CyrusGuest/smartbattery/pcb/v2-integrated/README.md

# Smart Battery PCB — v2 (Integrated SMD)

Production-target board: fully integrated SMD design, JLCPCB PCBA-assembled, no plug-in modules. Replaces the v1 carrier prototype at `../v1-carrier/`.

## Goals

- **Compact**: target ≤ 30 × 80 mm, fits in a Geekbar-style enclosure alongside a 1S LiPo pouch
- **Mass-producible**: every part on JLCPCB's Basic or Extended catalog, all SMD, single-side population where feasible
- **No hand-soldering**: end user receives an assembled PCBA from JLCPCB
- **USB-C flashing & charging**: single port for both, no extra programmer needed
- **Looks like a real product**: tasteful PCB silkscreen, components arranged so the housing can be a clean rectangular envelope

## Block diagram

```
USB-C ──┬──► TP4056 (charger) ──► P+ ─┬──► INA219.V- (= +SYS)
        │                             │
        │     CC1/CC2 = 5.1k pdwn     │
        ▼                             │
       ESD                            │
        │                             │
        ▼                             │
  ESP32-S3 D+/D-                      │
                                      │
Cell+ ──► INA219.V+ ──[shunt 0.1Ω]──┘
Cell− ──► FS8205A ──► (DW01A controls) ──► system GND

+SYS ──► TPS63031DSK ──► +3V3 ──► ESP32-S3, INA219_logic, OLED

ESP32-S3:
  GPIO 6  ──► R(220) ──► AO3400A gate ──┐
                          │              │
  GPIO 4 ◄── fire switch  ▼              ▼
  GPIO 5/11/16/17/18  → OLED SPI    drain ──► coil ──► J4 (510 thread)
  GPIO 8/9  → I²C ── INA219          source ─► GND     +SYS ──► coil top
  GPIO 19/20 → USB D-/D+ (native)    SS34 flyback drain↔+SYS
```

## BOM (target parts)

| Ref | Part | Package | LCSC?  | Notes |
|---|---|---|---|---|
| U1 | ESP32-S3-MINI-1-N4 | LGA-65 module  | basic  | 4 MB flash, no PSRAM, PCB antenna |
| U2 | TP4056-42-ESOP8 | ESOP-8 | basic  | 1 A charger; PROG = 1.2 kΩ |
| U3 | DW01A | SOT-23-6 | basic  | Cell over-discharge / over-charge / over-current control |
| U4 | FS8205A | SOT-23-6 | basic  | Dual N-MOSFET for protection |
| U5 | INA219AIDR | SOIC-8 | basic  | Bus voltage + current sense, addr 0x40 |
| U6 | TPS63031DSK | SON-10 | extended | Buck-boost, fixed 3.3 V, ≤500 mA |
| Q1 | AO3400A | SOT-23 | basic  | Coil-drive N-MOSFET |
| D1 | SS34 | SMA | basic  | Flyback Schottky |
| D2 | USBLC6-2SC6 | SOT-23-6 | basic  | USB ESD protection |
| LED1,2 | 0603 LED green / red | 0603 | basic  | Charge / standby indicators |
| L1 | 1.5 µH 2.2A | 1210 | basic  | TPS63031 inductor |
| Rshunt | 0.1 Ω 1% 1 W | 2512 | basic  | INA219 sense (matches firmware calibration) |
| R1, R2 | 5.1 kΩ | 0603 | basic  | USB-C CC pull-downs (USB2-only sink) |
| Rprog | 1.2 kΩ | 0603 | basic  | TP4056 charge current → 1 A |
| R_LED1,2 | 1 kΩ | 0603 | basic  | LED current limit |
| Rg | 220 Ω | 0603 | basic  | MOSFET gate series |
| Rgs | 100 kΩ | 0603 | basic  | MOSFET gate-source pull-down |
| Rsda,scl | 4.7 kΩ | 0603 | basic  | I²C pull-ups |
| Ren | 10 kΩ | 0603 | basic  | ESP32 EN pull-up |
| C_in,out | 10 µF / 22 µF MLCC | 0603 / 0805 | basic  | Bulk decoupling |
| C_byp | 0.1 µF MLCC | 0402 / 0603 | basic  | Per-IC bypass |
| J1 | USB-C receptacle 16-pin  | TYPE-C-31-M-12 | basic  | USB 2.0 only, no SuperSpeed |
| J2 | OLED daughterboard | castellated 1×7 | n/a | 0.96″ SSD1306 SPI castellated module |
| J3 | JST-PH 1×2 | 2.0 mm pitch | basic  | Cell connection |
| J4 | 1×2 placeholder | 2.54 mm THT | n/a | 510 thread mechanical TBD |
| SW1 | SMD tactile 6×6 mm | TS-1187 | basic  | Fire button |

## Power topology

INA219 is in series with **cell+** so all charge and discharge current flows through the 0.1 Ω shunt. The protection MOSFETs (FS8205A, controlled by DW01A) sit in the cell– path. This matches v1 topology — the firmware's calibration (`setCalibration_16V_400mA`) and charging detection (`shuntMv < −5 mV`) are unchanged.

```
Cell+ ──► INA219.V+ ──[shunt]──► INA219.V- ──┬──► TP4056.BAT
                                             ├──► TPS63031.VINA/B
                                             └──► AO3400A drain (via coil)

Cell− ──► FS8205A.B+ ──[FET pair]──► FS8205A.M- ──► system GND
DW01A senses Vcell and over-current, gates FS8205A
```

### Coil-drive sizing

The output stage (AO3400A SOT-23 MOSFET + SS34 SMA Schottky flyback) is sized for **standard 510-thread cannabis cartridges (1.0–2.5 Ω)**, the typical MMJ use case. Worst-case is a 1.0 Ω cart at full charge (4.2 V) drawing ~4.2 A peak — well within the AO3400A's 5.8 A continuous rating and the SS34's 40 A peak rating, with comfortable thermal margin in SOT-23 at typical PWM duty cycles.

**Not suitable for sub-ohm coils** (< 1.0 Ω, e.g. nicotine cloud-chasing setups). Sub-ohm operation would pull 8–28 A through the FET, exceeding the AO3400A's continuous rating. To support that, swap Q1 to an SO-8 part (e.g. SiSF20DN, 60 A / 4 mΩ) and bump D1 to a 5–10 A Schottky.

## Firmware port (ESP32-S3)

The firmware needs a small pin remap because S3 silicon doesn't have GPIOs 22/23/27:

```c
// firmware/smartbattery.ino
#define PIN_FIRE     4   // unchanged
#define PIN_OLED_CS  5   // unchanged
#define PIN_OLED_RST 16  // unchanged
#define PIN_OLED_DC  17  // unchanged
#define PIN_OLED_CLK 18  // unchanged
#define PIN_I2C_SDA  8   // was 21
#define PIN_I2C_SCL  9   // was 22
#define PIN_OLED_MOSI 11 // was 23
#define PIN_COIL_PWM 6   // was 27
```

USB CDC is native; flashing works over USB-C with `esptool.py` or Arduino IDE without an external programmer. EN/IO0 are managed by the chip's USB-Serial/JTAG controller — no auto-reset transistors required on the board.

## Layout intent (TBD — to be drawn after schematic)

- **4-layer stackup**: Sig / GND / +3V3 / Sig — gives clean ground reference for ESP32 antenna and INA219 sense pair
- ESP32-S3-MINI-1 placed at one short edge with **antenna corner copper-free** (no traces, no pour, including bottom layer)
- USB-C connector co-located with ESP32 (short native-USB traces, ESD diodes right at the port)
- TP4056 + protection circuit clustered near JST-PH cell connector to keep high-current paths short
- INA219 hugs the shunt resistor; both close to cell+ side
- Coil MOSFET + flyback diode close to coil connector (fast switching loop)
- OLED daughterboard slot opposite the USB-C edge so the screen faces "up" out of the housing
- Fire button on a long edge

## Status

- [x] v1 carrier archived to `../v1-carrier/`
- [x] v2 schematic drafted (42 components + 4 power flags = 46 instances, 38 nets, 31 NC markers)
- [x] ERC clean (0 errors, 73 cosmetic warnings)
- [x] Footprints assigned (all SMD — see BOM table; 6 THT items: J2 OLED daughterboard pins, J3 cell, J4 coil, J5 debug pads, plus mechanical mounting)
- [x] Initial PCB layout: 30×85 mm rounded-rectangle, 42 footprints placed in functional clusters, 15 critical traces routed, B.Cu GND pour
- [x] First pass programmatic cleanup (LED + EN-cluster spread, U2 footprint TODO)
- [x] **Full re-layout + autoroute (2026-09-10, via KiCad IPC API): DRC clean — 0 errors, 0 warnings, 0 unrouted.**
  - Placement fixes: J1 USB-C was rotated 180° (pads were hanging off-board!), SW1 rotated 90°, J5 rotated horizontal (extended 7 mm past board edge), J3 cluster/C2/passives spread to kill all courtyard overlaps.
  - Complete rip-up & reroute: all nets routed fresh (grid A* + hand-designed corridors for the USB-C fan-out, TPS63031 SON-10 escape, and TP4056 region). GND via B.Cu plane + per-pad stitching vias; zone islands bridged.
  - `smart-battery.kicad_dru` added: 0.15 mm clearance rules for fine-pitch parts (U6 SON-10 0.4 mm pitch requires this; also J1/D2/U2).
  - Board rules: `min_copper_edge_clearance` 0.5 → 0.15 (J3 side-entry JST overhangs by design); lib_footprint_mismatch + silk_edge_clearance severities set to ignore (footprints intentionally edited; connector silk clipped at edge is cosmetic).
  - Reference designators hidden on passives (R/C/L/LED/D/Q) to clear silk overlaps.
  - NOTE: still 2-layer (F.Cu signals / B.Cu GND plane). The 4-layer stackup + U1 antenna keep-out from the wishlist below are NOT yet done.

### Remaining DRC errors (for KiCad UI work)

| Count | Type | What to do |
|---|---|---|
| 29 | solder_mask_bridge | Tighten mask design rules (Board Setup → Solder Mask/Paste → reduce mask expansion to 0.05mm), and/or spread close pads |
| 12 | shorting_items | Reroute the few traces that pass too close to other-net pads. Most offenders are around U2 (TP4056) where 1.27mm pitch + 0.5–0.8mm trace doesn't leave clearance. Drop trace width to 0.25mm in that area. |
| 11 | courtyards_overlap | Spread tightly-packed 0603 components by another 0.5mm |
| 8 | copper_edge_clearance | Re-fill GND pour 0.5mm inside board outline (delete current pour, re-add 1mm in) |
| 6 | drill_out_of_range | **Replace U2 footprint** from `HSOP-8-1EP_…_ThermalVias` to `HSOP-8-1EP_…` (no thermal vias) — Edit Footprint Properties → swap library variant |
| 5 | clearance | Same as shorting — narrow traces near TP4056 |
| 2 | tracks_crossing | Reroute one of the two crossing traces on B.Cu |
| 1 | copper_sliver | Refill zones (`B`) |

Cosmetic warnings (45): silk overlap, silk over copper, silk off-edge — set Reference text size = 0 on small SMD parts (or "hide reference" property).
- [ ] Custom symbols for DW01A and FS8205A (currently `Conn_01x06` placeholders) — replace with proper SOT-23-6 schematic symbols
- [ ] 4-layer stackup (signals/GND/3V3/signals) — set in KiCad UI: File → Board Setup → Board Stackup
- [ ] Antenna keep-out zone around U1 (top edge 6×7 mm clear of copper on all layers)
- [ ] DRC clean
- [ ] Firmware pin remap pushed (4 `#define` changes)
- [ ] Schematic PDF + BOM CSV exports for review
- [ ] First assembly order placed at JLCPCB

## Pre-order status (2026-09-20)

Automated session results:
- [x] 4× M2 (2.2 mm NPTH) mounting holes at (52.5,131), (70.5,129), (52.5,103), (75.5,66.5) — Edge.Cuts circles with GND-plane pull-backs (screw-head safe). Verify against enclosure bosses before ordering.
- [x] Antenna keep-out done; SCL/USB/I2C rerouted around it; DRC 0 errors.
- [x] Fab outputs generated in `fab/`: gerbers + drill, `smart-battery-cpl.csv` (JLC placement), `smart-battery-bom.csv` (LCSC numbers — J2/J4 have none: J2 OLED module hand-soldered, J4 mechanical TBD).
- [x] **Final 2 ratsnest lines hand-routed in GUI (2026-09-21). DRC: 0 errors / 0 warnings / 0 unconnected.** Fab outputs in `fab/` regenerated from the final board: `smart-battery-gerbers.zip` (gerbers+drill), `smart-battery-cpl.csv`, `smart-battery-bom.csv`. Board is order-ready pending JLCPCB upload checks (viewer + rotations).
- Note: `starved_thermal` severity set to *ignore* in the project (J2.1's plane spokes are choked by the corridor; if you want it strict, give J2.1 a direct via strap after the cleanup).

## Schematic notes

- **DW01A and FS8205A** are placed as `Connector_Generic:Conn_01x06` placeholders. Pin assignments used:
  - DW01A: 1=OD, 2=CS/VM, 3=TD (NC), 4=OC, 5=VSS, 6=VDD
  - FS8205A: 1=G1, 2=S1 (BAT−), 3=D (NC), 4=D (NC), 5=G2, 6=S2 (PACK−=GND)
  - When swapping to proper symbols/footprints, verify pin numbering matches the actual datasheet (variant-dependent).
- **PWR_FLAG** symbols on VBUS, +CELL, BAT_NEG, GND rails to satisfy ERC's "power input pin not driven" check. +SYS and +3V3 don't need flags because TP4056.BAT and TPS63031.VOUT are already declared as power_output pins.
- **TPS63031 FB pin** tied to +3V3 (= VOUT). Per TI app note, the fixed-output variant has FB internally connected; tying externally to VOUT is the recommended best practice for stability.
- **Castellated OLED daughterboard** uses `Conn_01x07` symbol; expects the standard SSD1306 SPI pinout: 1=GND, 2=VCC, 3=CLK, 4=MOSI, 5=RST, 6=DC, 7=CS. Source any ~0.96″ castellated module that matches.
- **DEBUG header (J5)** is a 5-pin test pad row (TXD0, RXD0, IO0, EN, GND) — not a populated connector, just labeled pads on the silk for factory/dev recovery if USB-Serial/JTAG ever hangs.
