CyrusGuest/smartbattery/pcb/v2-integrated/fab/smart-battery-board.step

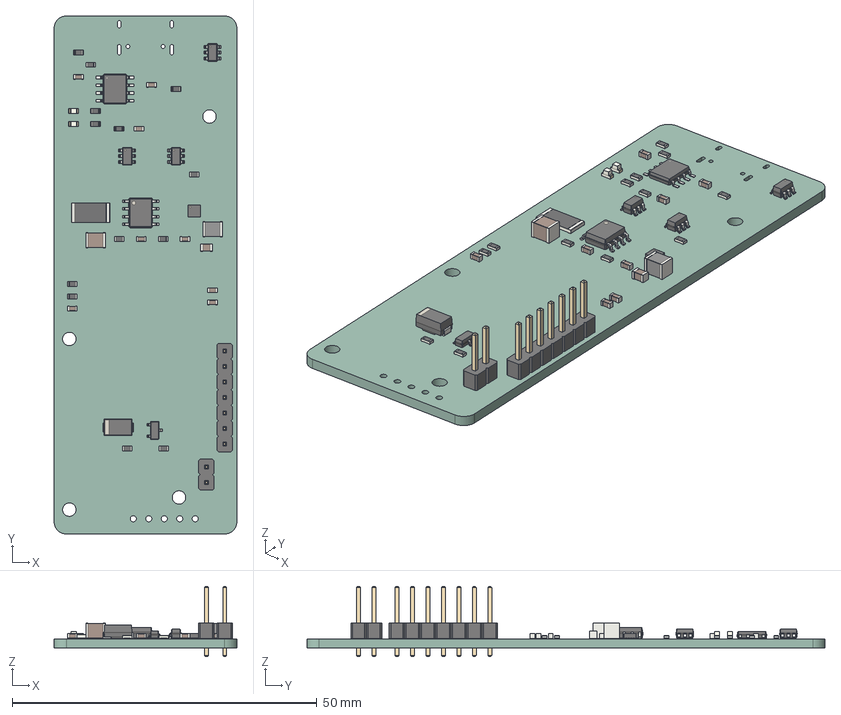
[picture p1: CAD file, 2026-09-30]
pcb/v2-integrated/fab/smart-battery-board.step
30.0 x 85.0 x 11.5 mm
LED_0603_1608Metric x 2
SOT-23-6 x 3
R_0603_1608Metric x 13
C_0805_2012Metric
HSOP-8-1EP_3.9x4.9mm_P1.27mm_EP2.41x3.1mm
C_0603_1608Metric x 8
Texas_DSQ0010A_WSON-10-1EP_2x2mm_P0.4mm_EP0.9x1.5mm
SOT-23
PinHeader_1x07_P2.54mm_Vertical
SOIC-8_3.9x4.9mm_P1.27mm
R_2512_6332Metric
PinHeader_1x02_P2.54mm_Vertical
C_1210_3225Metric
D_SMA
L_1210_3225Metric
smart-battery_PCB
