CyrusGuest/smartbattery/pcb/v2-integrated/smart-battery-schematic.pdf

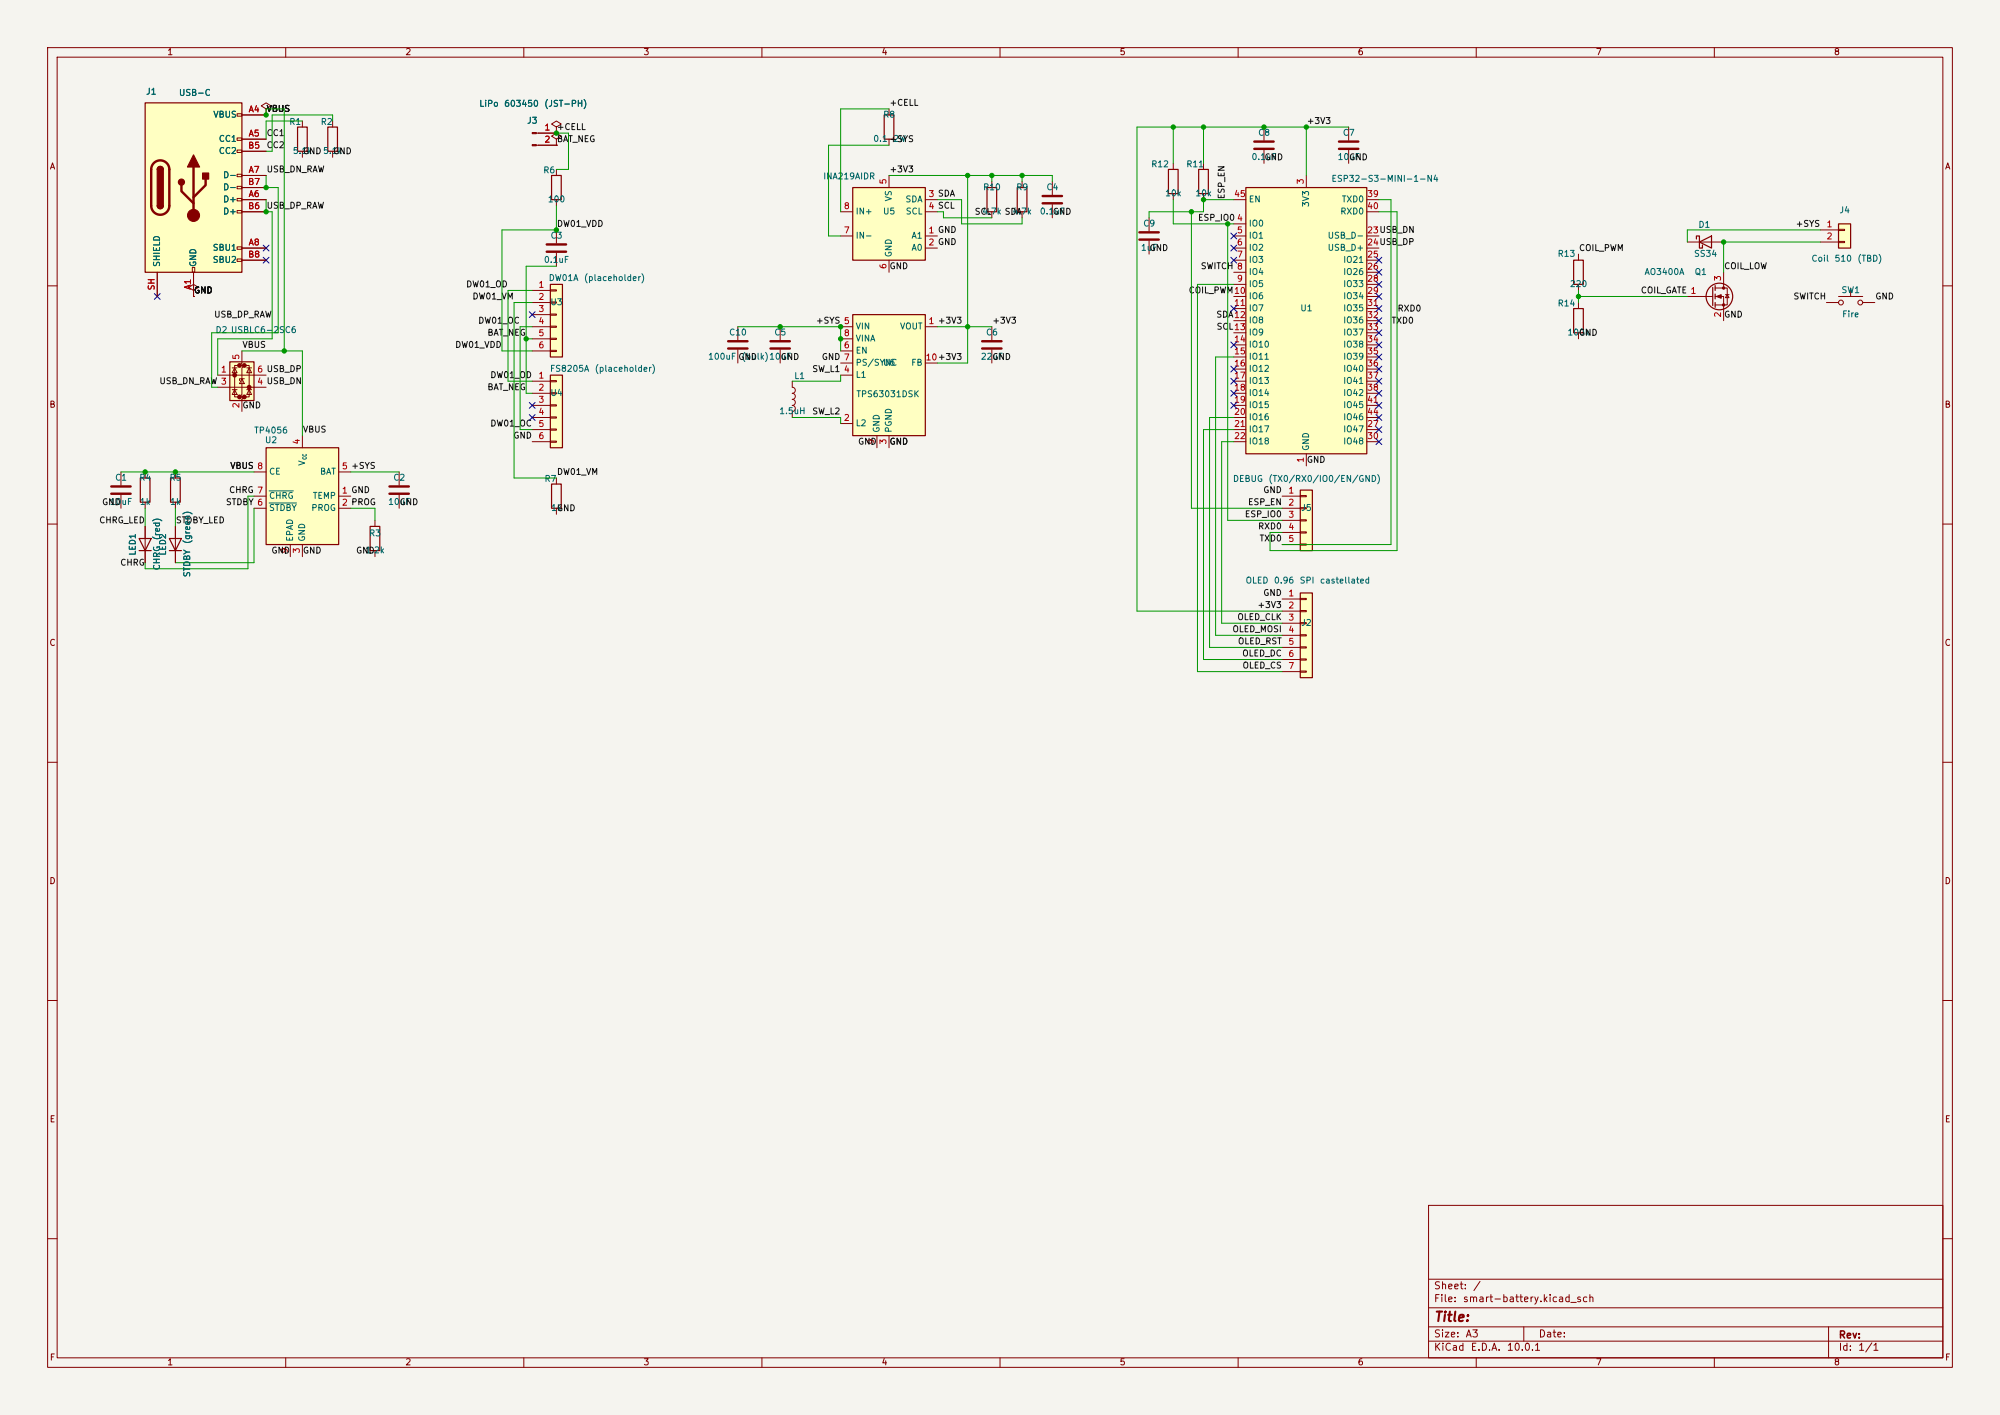
[picture p2: page 1]

Size: A3 | Rev: | F Date:
KiCad E.D.A. 10.0.1 | Id: 1/1
