CyrusGuest/smartbattery/(list of files, drawings)

Other design files:
pcb/v2-integrated/smart-battery.dsn
