CyrusGuest/smartbattery/pcb/v1-carrier/smart-battery.kicad_pcb

## KiCad design pcb/v1-carrier/smart-battery.kicad_pcb (2026-09-30)

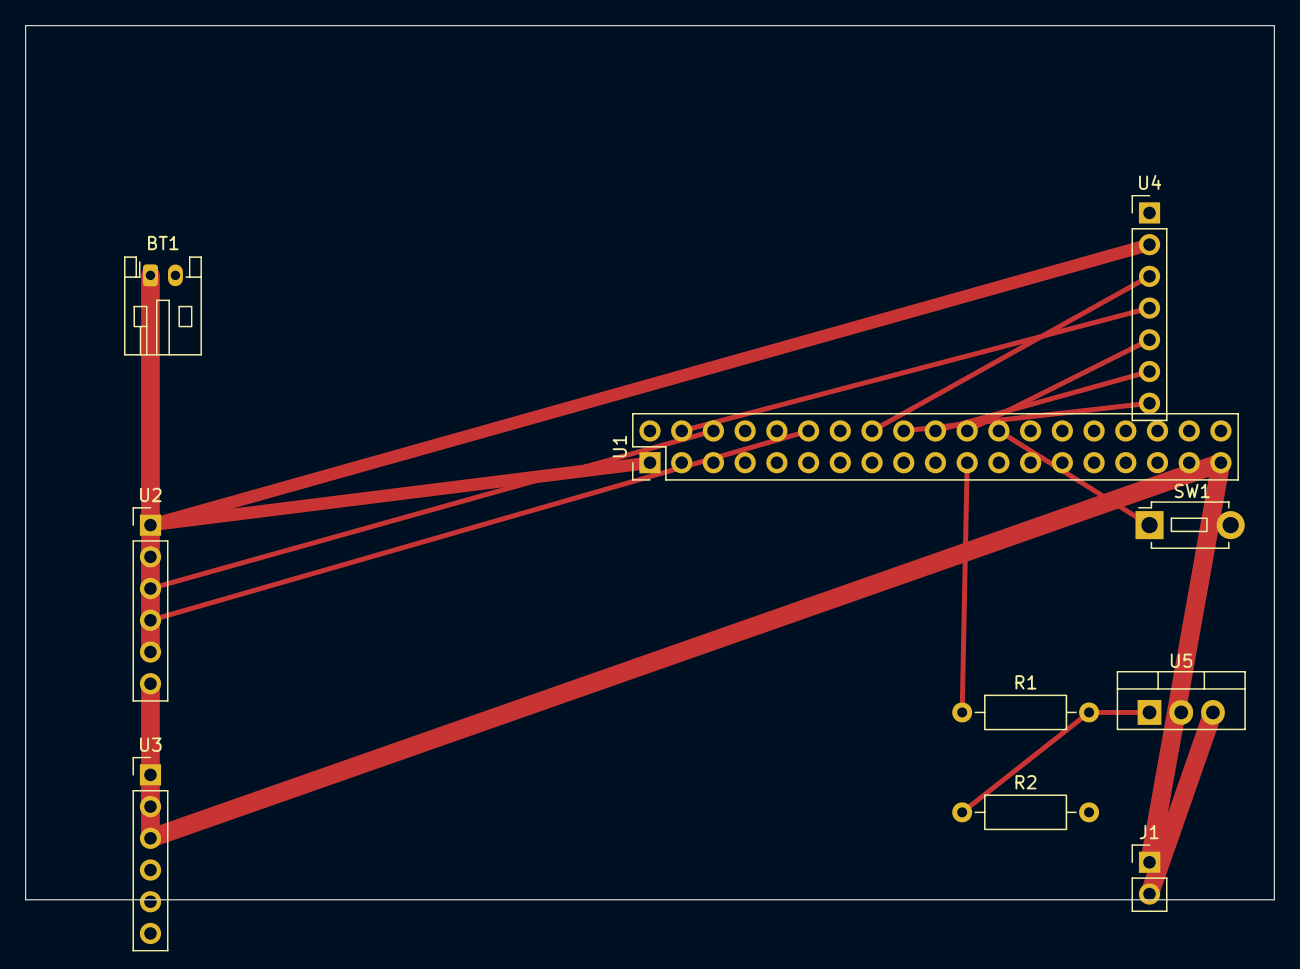
[picture p3: board pcb/v1-carrier/smart-battery.kicad_pcb from above]

Board: 2 copper layers, 100.0 x 70.0 mm, 10 parts (0 on the bottom side), 15 nets.

Parts:
BT1: LiPo 1S; JST_PH_S2B-PH-K_1x02_P2.00mm_Horizontal
J1: Coil; PinHeader_1x02_P2.54mm_Vertical
R1: 220; R_Axial_DIN0207_L6.3mm_D2.5mm_P10.16mm_Horizontal
R2: 100k; R_Axial_DIN0207_L6.3mm_D2.5mm_P10.16mm_Horizontal
SW1: Fire; SW_PUSH_1P1T_6x3.5mm_H4.3_APEM_MJTP1243
U1: ESP32 38-pin; PinHeader_2x19_P2.54mm_Vertical
U2: INA219; PinHeader_1x06_P2.54mm_Vertical
U3: TP4056; PinHeader_1x06_P2.54mm_Vertical
U4: OLED; PinHeader_1x07_P2.54mm_Vertical
U5: N-MOSFET; TO-220-3_Vertical

Connections:
+3V3: U1.1, U2.1, U4.2
+CELL: BT1.1, U2.5
+SYS: J1.1, U1.37, U2.6, U3.1, U3.3
COIL_GATE: R1.2, R2.1, U5.1
COIL_LOW: J1.2, U5.3
COIL_PWM: R1.1, U1.21
GND: BT1.2, R2.2, SW1.2, U1.2, U1.27, U1.38, U2.2, U3.2, U3.4, U4.1, U5.2
OLED_CLK: U1.16, U4.3
OLED_CS: U1.18, U4.7
OLED_DC: U1.20, U4.6
OLED_MOSI: U1.4, U4.4
OLED_RST: U1.22, U4.5
SCL: U1.6, U2.3
SDA: U1.12, U2.4
SWITCH: SW1.1, U1.24
