CyrusGuest/smartbattery/pcb/v2-integrated/smart-battery.kicad_pcb

## KiCad design pcb/v2-integrated/smart-battery.kicad_pcb (2026-09-30)

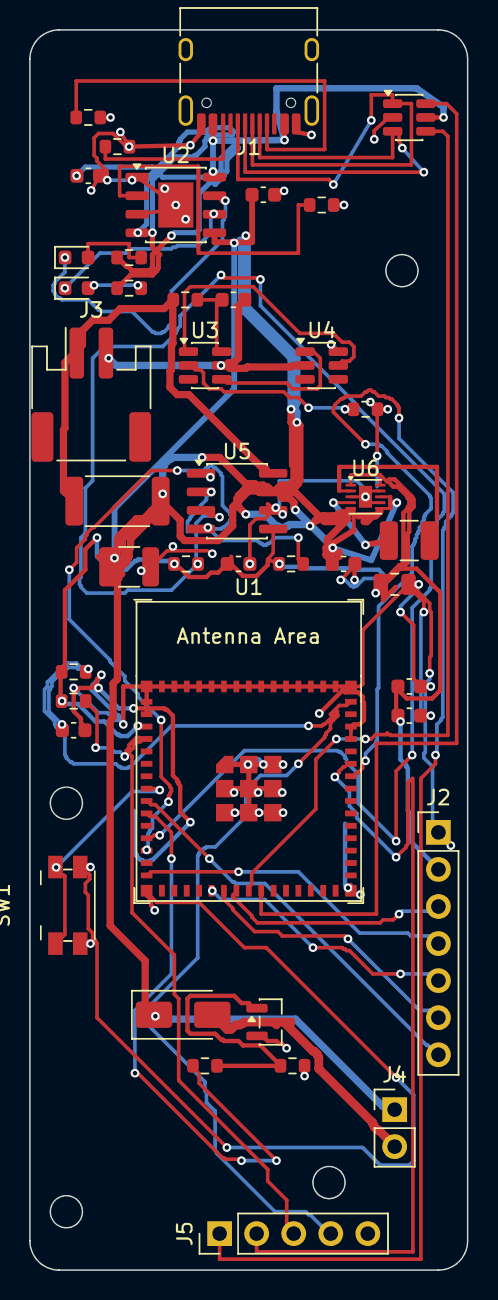
[picture p4: board pcb/v2-integrated/smart-battery.kicad_pcb from above]

Board: 2 copper layers, 30.0 x 85.0 mm, 42 parts (0 on the bottom side), 38 nets.

Parts:
C1, C2, C5, C7: 10uF; C_0603_1608Metric
C3, C4, C8: 0.1uF; C_0603_1608Metric
C6: 22uF; C_0805_2012Metric
C9: 1uF; C_0603_1608Metric
C10: 100uF; C_1210_3225Metric
D1: SS34; D_SMA
D2: USBLC6-2SC6; SOT-23-6
J1: USB-C; USB_C_Receptacle_HRO_TYPE-C-31-M-12
J2: OLED; PinHeader_1x07_P2.54mm_Vertical
J3: LiPo 1S; JST_PH_S2B-PH-SM4-TB_1x02-1MP_P2.00mm_Horizontal
J4: Coil 510; PinHeader_1x02_P2.54mm_Vertical
J5: DEBUG; PinHeader_1x05_P2.54mm_Vertical
L1: 1.5uH; L_1210_3225Metric
LED1: CHRG (red); LED_0603_1608Metric
LED2: STDBY (green); LED_0603_1608Metric
Q1: AO3400A; SOT-23
R1, R2: 5.1k; R_0603_1608Metric
R3: 1.2k; R_0603_1608Metric
R4, R5, R7: 1k; R_0603_1608Metric
R6: 100; R_0603_1608Metric
R8: 0.1 1W; R_2512_6332Metric
R9, R10: 4.7k; R_0603_1608Metric
R11, R12: 10k; R_0603_1608Metric
R13: 220; R_0603_1608Metric
R14: 100k; R_0603_1608Metric
SW1: Fire; Panasonic_EVQPUJ_EVQPUA
U1: ESP32-S3-MINI-1-N4; ESP32-S3-MINI-1
U2: TP4056; HSOP-8-1EP_3.9x4.9mm_P1.27mm_EP2.41x3.1mm
U3: DW01A; SOT-23-6
U4: FS8205A; SOT-23-6
U5: INA219; SOIC-8_3.9x4.9mm_P1.27mm
U6: TPS63031; Texas_DSQ0010A_WSON-10-1EP_2x2mm_P0.4mm_EP0.9x1.5mm

Connections:
+3V3: C4.1, C6.1, C7.1, C8.1, J2.2, R9.1, R10.1, R11.1, R12.1, U1.3, U5.5, U6.1, U6.10
+CELL: J3.1, R6.1, R8.1, U5.8
+SYS: C2.1, C5.1, C10.1, D1.1, J4.1, R8.2, U2.5, U5.7, U6.5, U6.6, U6.8
BAT_NEG: C3.2, J3.2, U3.5, U4.2
CC1: J1.A5, R1.1
CC2: J1.B5, R2.1
CHRG: LED1.1, U2.7
CHRG_LED: LED1.2, R4.2
COIL_GATE: Q1.1, R13.2, R14.1
COIL_LOW: D1.2, J4.2, Q1.3
COIL_PWM: R13.1, U1.10
DW01_OC: U3.4, U4.1
DW01_OD: U3.1, U4.5
DW01_VDD: C3.1, R6.2, U3.6
DW01_VM: R7.1, U3.2
ESP_EN: C9.1, J5.4, R11.2, U1.45
ESP_IO0: J5.3, R12.2, U1.4
GND: C1.2, C2.2, C4.2, C5.2, C6.2, C7.2, C8.2, C9.2, C10.2, D2.2, J1.A1, J1.A12, J1.B1, J1.B12, J2.1, J5.5, Q1.2, R1.2, R2.2, R3.2, R7.2, R14.2, SW1.2, U1.1, U1.2, U1.42, U1.43, U1.46, U1.47, U1.48, U1.49, U1.50, U1.51, U1.52, U1.53, U1.54, U1.55, U1.56, U1.57, U1.58, U1.59, U1.60, U1.61, U1.62, U1.63, U1.64, U1.65, U2.1, U2.3, U2.9, U4.6, U5.1, U5.2, U5.6, U6.3, U6.7, U6.9, U6.11
OLED_CLK: J2.3, U1.22
OLED_CS: J2.7, U1.9
OLED_DC: J2.6, U1.21
OLED_MOSI: J2.4, U1.15
OLED_RST: J2.5, U1.20
PROG: R3.1, U2.2
RXD0: J5.2, U1.40
SCL: R10.2, U1.13, U5.4
SDA: R9.2, U1.12, U5.3
STDBY: LED2.1, U2.6
STDBY_LED: LED2.2, R5.2
SWITCH: SW1.1, U1.8
SW_L1: L1.1, U6.4
SW_L2: L1.2, U6.2
TXD0: J5.1, U1.39
USB_DN: D2.4, U1.23
USB_DN_RAW: D2.3, J1.A7, J1.B7
USB_DP: D2.6, U1.24
USB_DP_RAW: D2.1, J1.A6, J1.B6
VBUS: C1.1, D2.5, J1.A4, J1.A9, J1.B4, J1.B9, R4.1, R5.1, U2.4, U2.8
