CyrusGuest/smartbattery/(commit log)

2026-04-13 Add firmware, update .gitignore, remove swap file
    [smartbattery.ino]
2026-04-27 Document hardware wiring and PCB punch list
    HARDWARE.md captures the pin map, I2C/SPI peripherals, INA219 topology
    (in-line with cell+, USB-C charger and loads on V- side), and BLE GATT
    contract — reconstructed from firmware since no PCB files exist.
    PCB-TODO.md tracks unknowns to nail down for a real board layout:
    charger module part, ESP32 supply path, MOSFET selection, coil
    connector, INA219 shunt vs. calibration tradeoff.
2026-04-27 Remove NeoPixel — not in physical design
    Strip out Adafruit_NeoPixel include, NEOPIXEL_PIN, NUM_PIXELS,
    LED_BRIGHTNESS, the strip object, setLedsIdle/setLedsFiring functions
    and their callers from enterState(), plus the LED init in setup().
    OLED already conveys idle/firing state, so no UX is lost.
    Update HARDWARE.md and PCB-TODO.md to drop NeoPixel from the block
    diagram, pin map, power tree, and parts decisions.
2026-04-27 Scaffold pcb/ with KiCad workflow guide
    Adds pcb/README.md as a roadmap for the carrier PCB: KiCad first-run
    setup, schematic plan (symbols + nets translated from HARDWARE.md),
    footprint suggestions, and a workflow checklist.
    The directory is intentionally otherwise empty — the user creates the
    .kicad_pro / .kicad_sch from KiCad's GUI (kicad-cli has no project-new
    command). Once those exist, files are plain-text S-expressions that
    can be diffed and reviewed here.
2026-04-27 Add .mcp.json.example for KiCad MCP server
    Project-scoped MCP server config (.mcp.json itself is gitignored
    because it has absolute paths). Example file documents the install
    procedure: clone mixelpixx/KiCAD-MCP-Server, npm install + build,
    brew install --cask kicad, fill in machine-specific paths, restart
    Claude Code.
2026-09-30 Add v2-integrated PCB: routed board (DRC 0/0/0), fab outputs, JLC BOM fixes
    - Full board layout: 30x85mm, ESP32-S3, TP4056+DW01A/FS8205A, INA219, TPS63031
    - Antenna keep-out, 4x M2 mounting holes, custom DRC rules (.kicad_dru)
    - fab/: gerbers zip, JLC-format BOM+CPL, board STEP export
    - BOM annotated with JLC engineering-review part replacements (0402->0603 etc)
    - PCBA order SMT026092263342_Y3 placed 2026-09-22
    Claude-Session: https://claude.ai/code/session_01PWAUQNvm7Y4gbk26uvd3Ky
    [smart-battery-B_Courtyard.gbr, smart-battery-B_Cu.gbl, smart-battery-B_Fab.gbr, smart-battery-B_Mask.gbs, smart-battery-B_Paste.gbp, smart-battery-B_Silkscreen.gbo, smart-battery-Edge_Cuts.gm1, smart-battery-F_Courtyard.gbr]
2026-09-30 Ignore KiCad lock files and .history dir
    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
